regnaDkciN/GenevaClock/STL Files/Full Post.stl

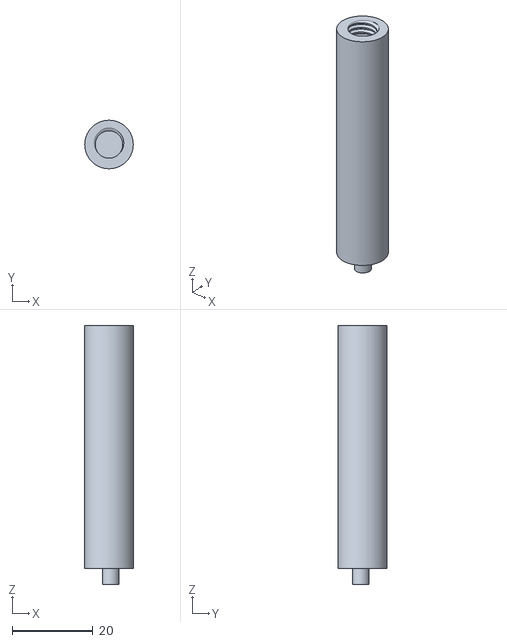
[picture p1: CAD file, 2024-05-16]
STL Files/Full Post.stl
12.0 x 12.0 x 64.0
