regnaDkciN/GenevaClock/STL Files/Geneva Axle.stl

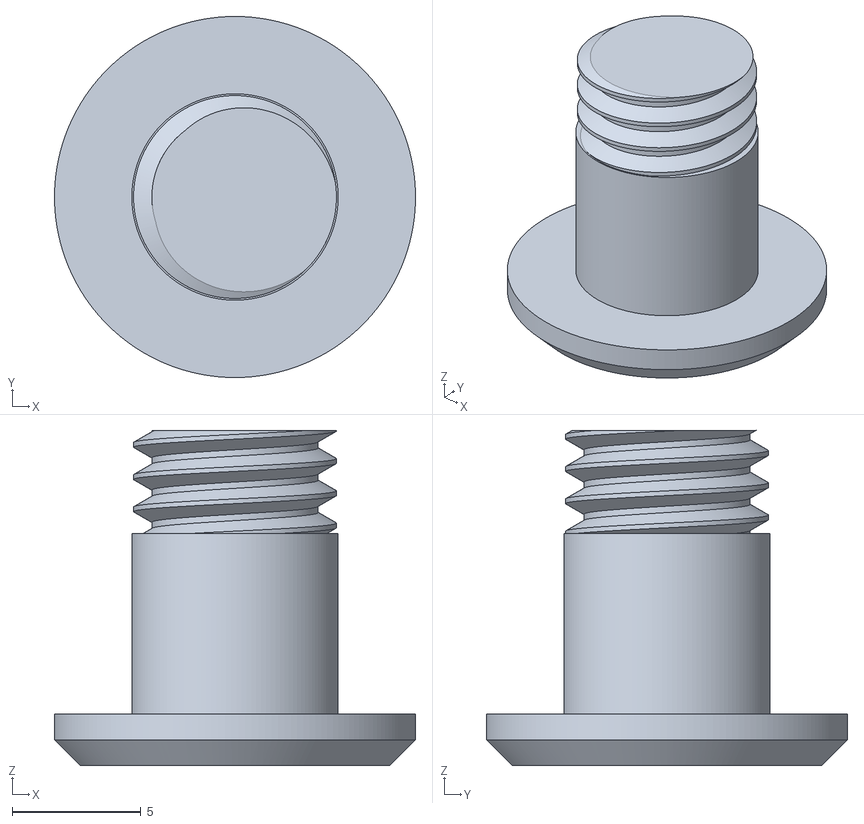
[picture p2: CAD file, 2024-05-16]
STL Files/Geneva Axle.stl
14.0 x 14.0 x 13.0
