regnaDkciN/GenevaClock/STL Files/Gear (1.5m 8t).stl

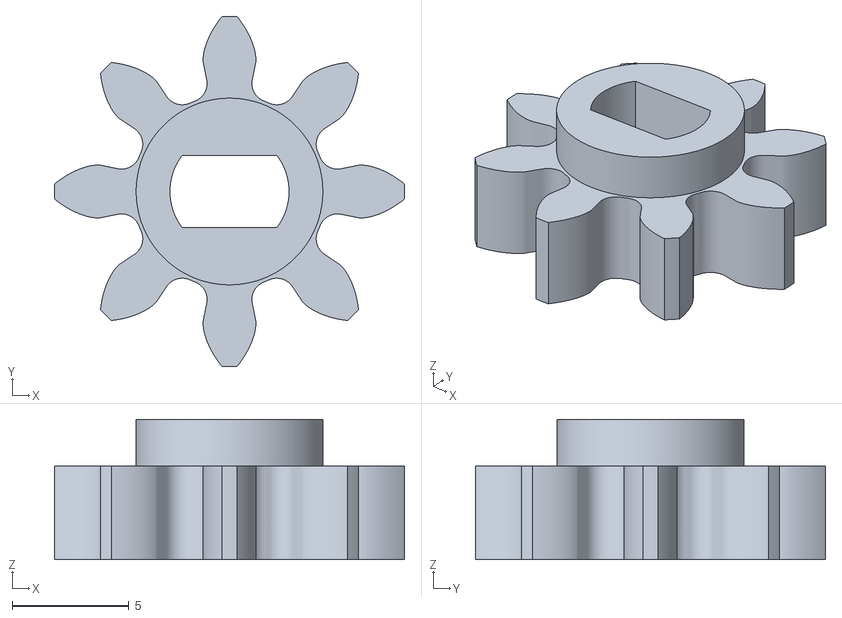
[picture p3: CAD file, 2024-05-16]
STL Files/Gear (1.5m 8t).stl
15.0 x 15.0 x 6.00
