regnaDkciN/GenevaClock/STL Files/Geneva 2 Black.stl

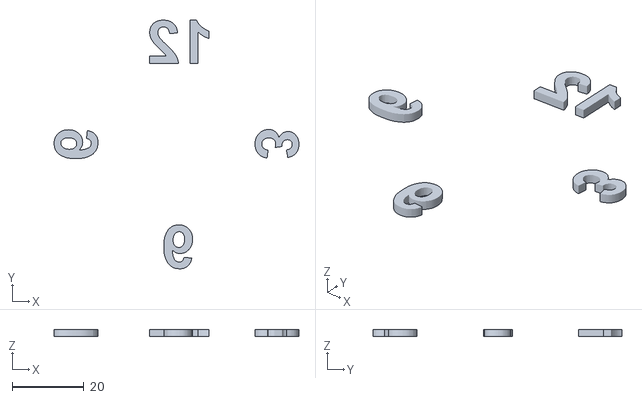
[picture p4: CAD file, 2024-05-16]
STL Files/Geneva 2 Black.stl
68.1 x 69.2 x 2.00
