regnaDkciN/GenevaClock/STL Files/Geneva Clock Box Lid.stl

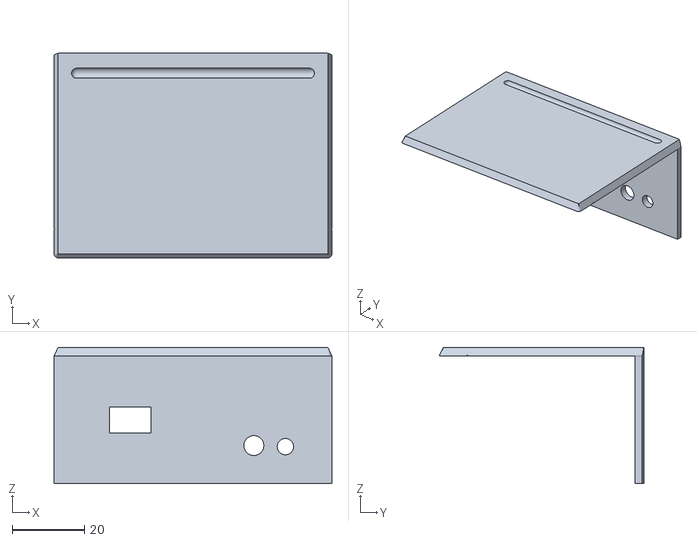
[picture p5: CAD file, 2024-05-16]
STL Files/Geneva Clock Box Lid.stl
76.7 x 56.5 x 37.6
