regnaDkciN/GenevaClock/STL Files/Face Black.stl

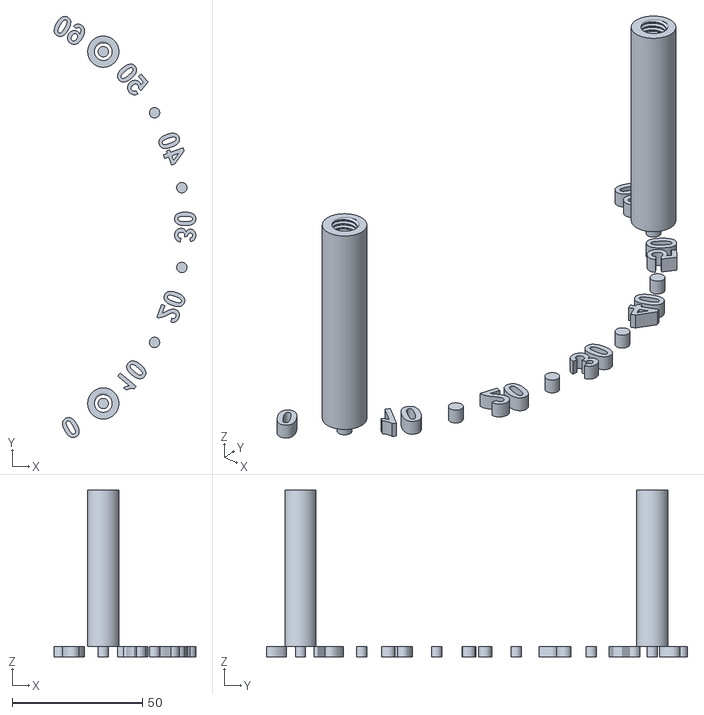
[picture p6: CAD file, 2024-05-16]
STL Files/Face Black.stl
54.3 x 161.5 x 64.0
