regnaDkciN/GenevaClock/STL Files/Geneva 1 White.stl

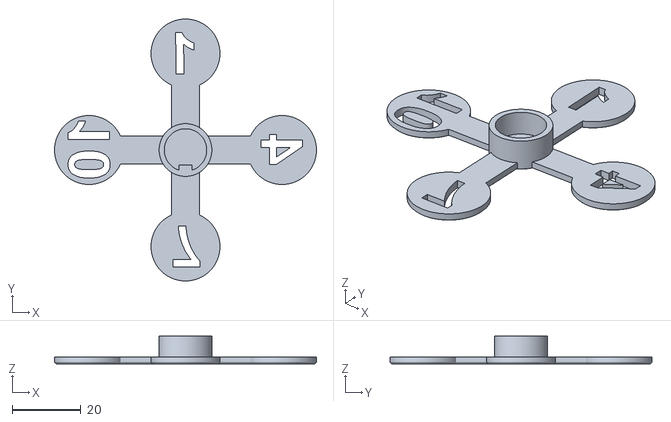
[picture p7: CAD file, 2024-05-16]
STL Files/Geneva 1 White.stl
76.0 x 76.0 x 8.00
