regnaDkciN/GenevaClock/STL Files/Cam.stl

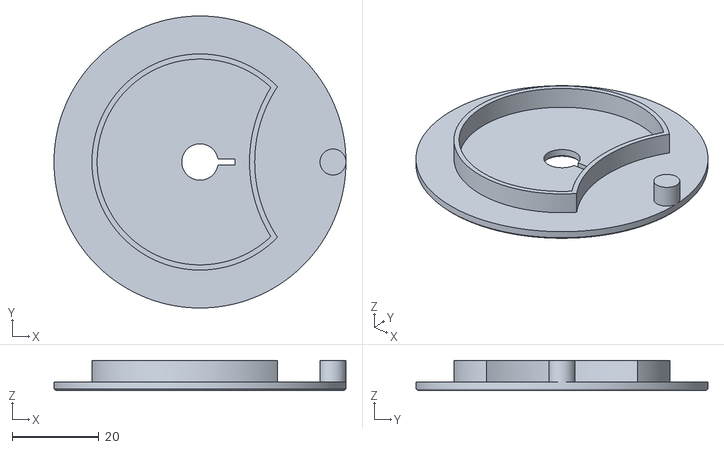
[picture p9: CAD file, 2024-05-16]
STL Files/Cam.stl
67.4 x 67.4 x 7.00
