regnaDkciN/GenevaClock/STL Files/Face.3mf

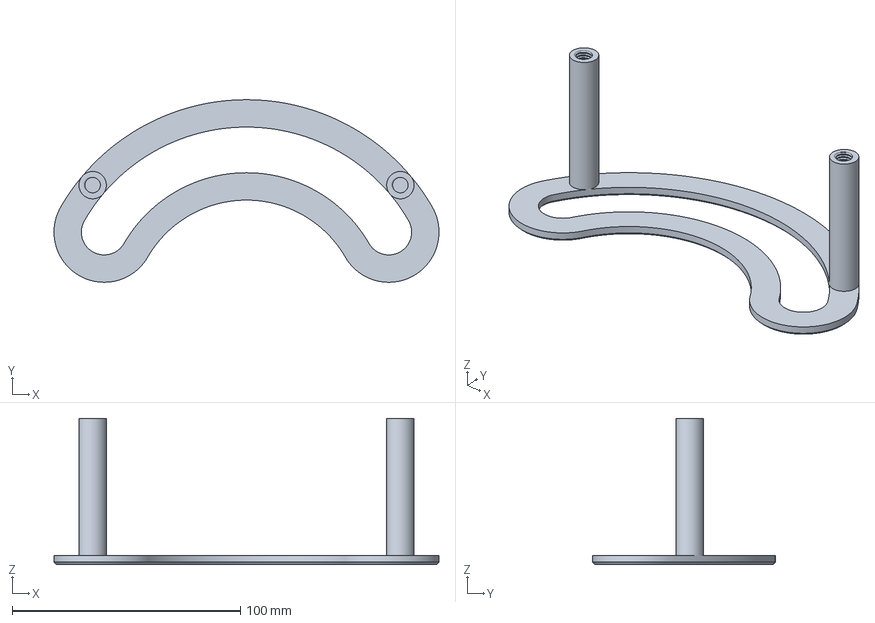
[picture p11: CAD file, 2024-05-16]
STL Files/Face.3mf
168.7 x 80.0 x 64.0 mm
