regnaDkciN/GenevaClock/STL Files/Reed Mount.stl

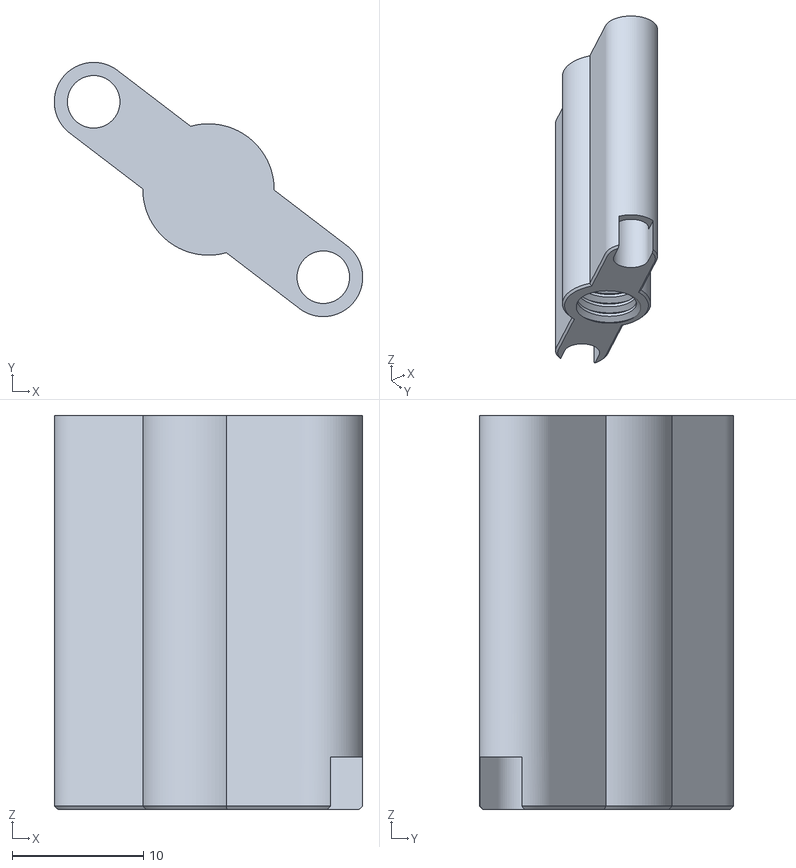
[picture p12: CAD file, 2024-05-16]
STL Files/Reed Mount.stl
23.5 x 19.4 x 30.0
