regnaDkciN/GenevaClock/STL Files/Bracket.stl

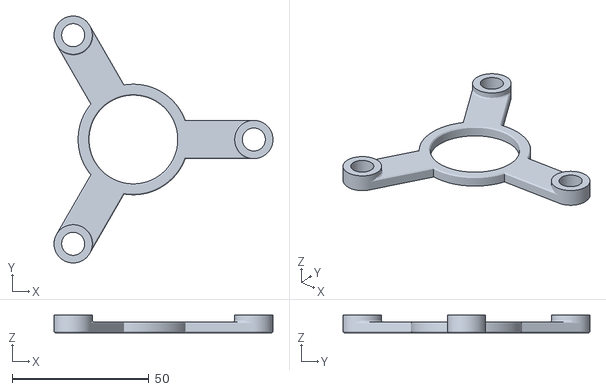
[picture p13: CAD file, 2024-05-16]
STL Files/Bracket.stl
80.0 x 90.2 x 6.40
