regnaDkciN/GenevaClock/STL Files/Back.stl

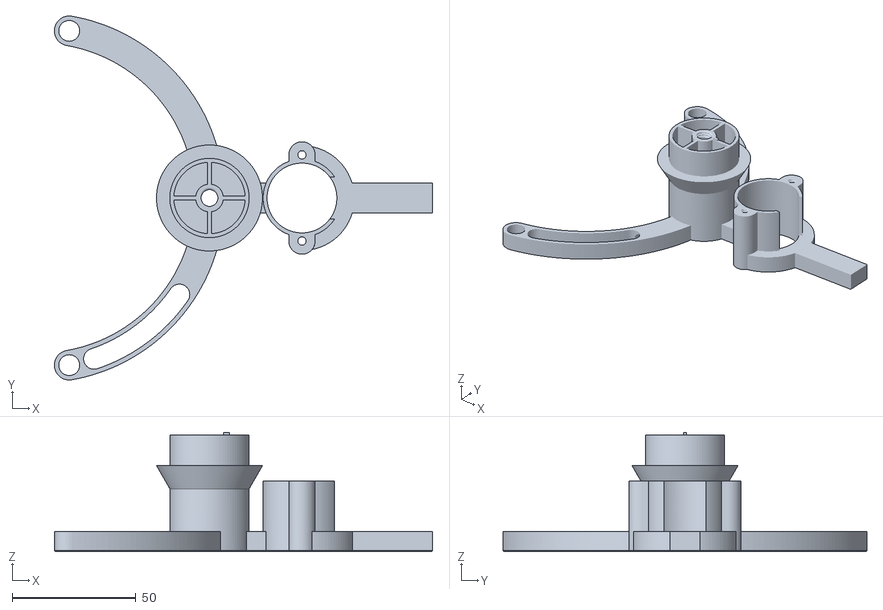
[picture p14: CAD file, 2024-05-16]
STL Files/Back.stl
152.6 x 146.8 x 48.0
