regnaDkciN/GenevaClock/STL Files/Stand.stl

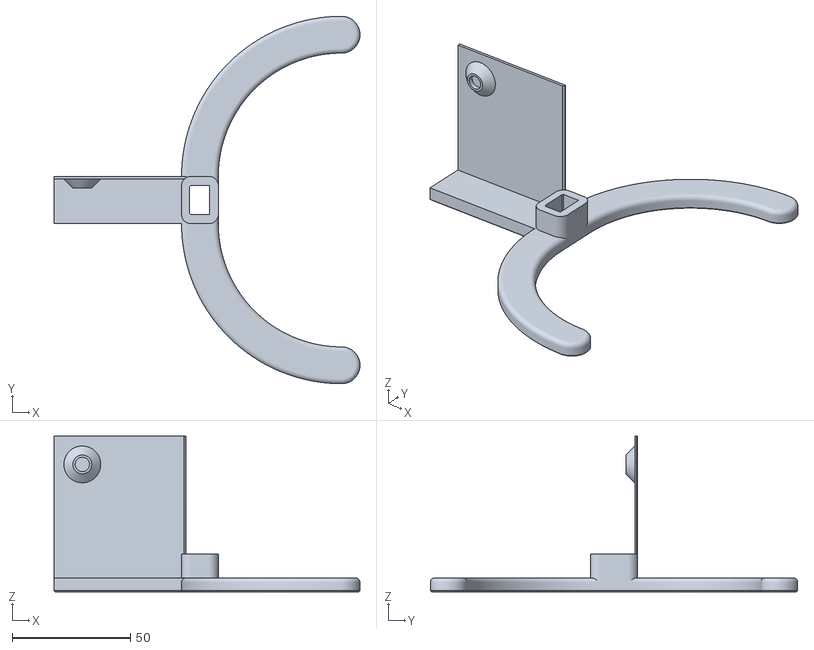
[picture p15: CAD file, 2024-05-16]
STL Files/Stand.stl
129.6 x 155.6 x 66.0
