regnaDkciN/GenevaClock/STL Files/Face With Mounts.stl

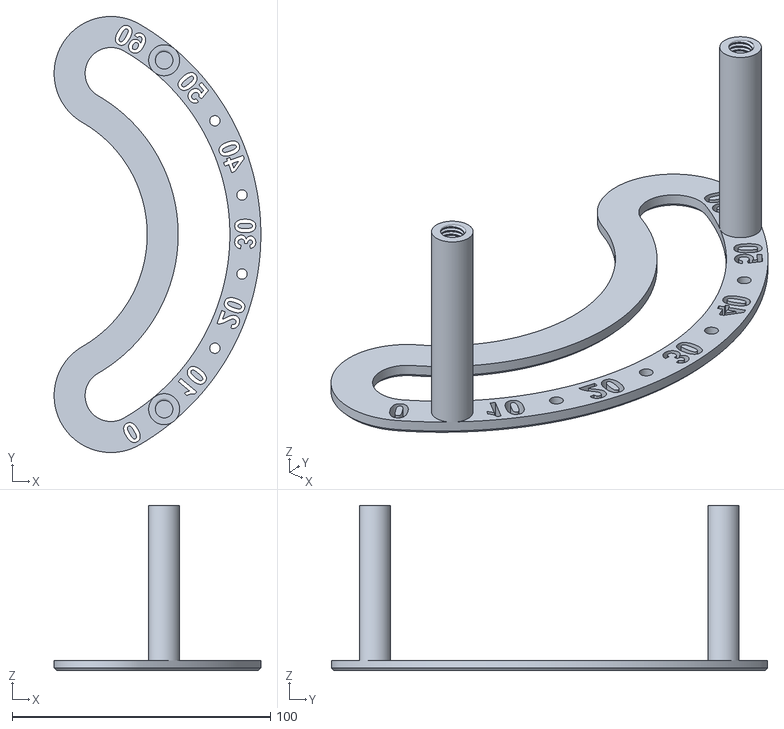
[picture p16: CAD file, 2024-05-16]
STL Files/Face With Mounts.stl
80.0 x 168.7 x 64.0
