regnaDkciN/GenevaClock/STL Files/Geneva 2.3mf

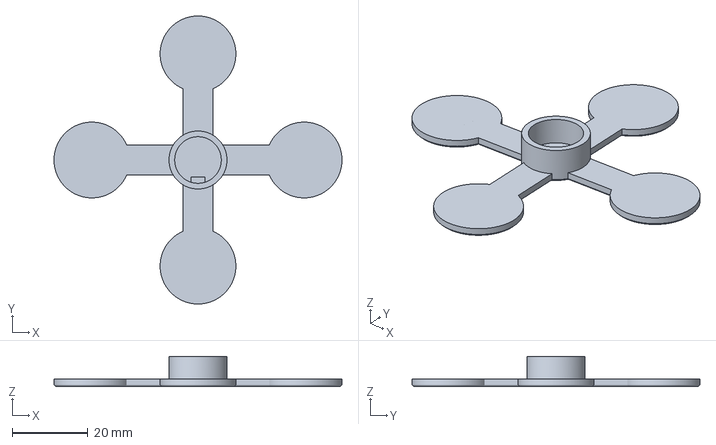
[picture p17: CAD file, 2024-05-16]
STL Files/Geneva 2.3mf
76.0 x 76.0 x 8.00 mm
