regnaDkciN/GenevaClock/STL Files/Geneva 1 Black.stl

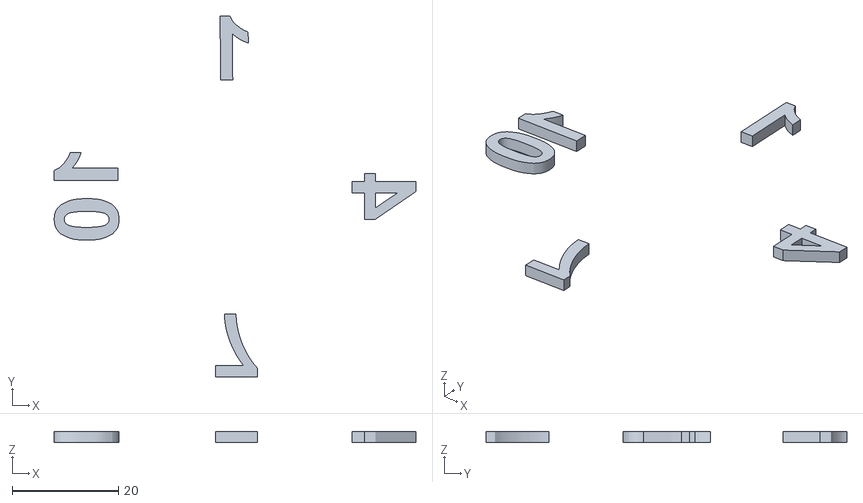
[picture p18: CAD file, 2024-05-16]
STL Files/Geneva 1 Black.stl
68.1 x 67.9 x 2.00
