regnaDkciN/GenevaClock/STL Files/Face White.stl

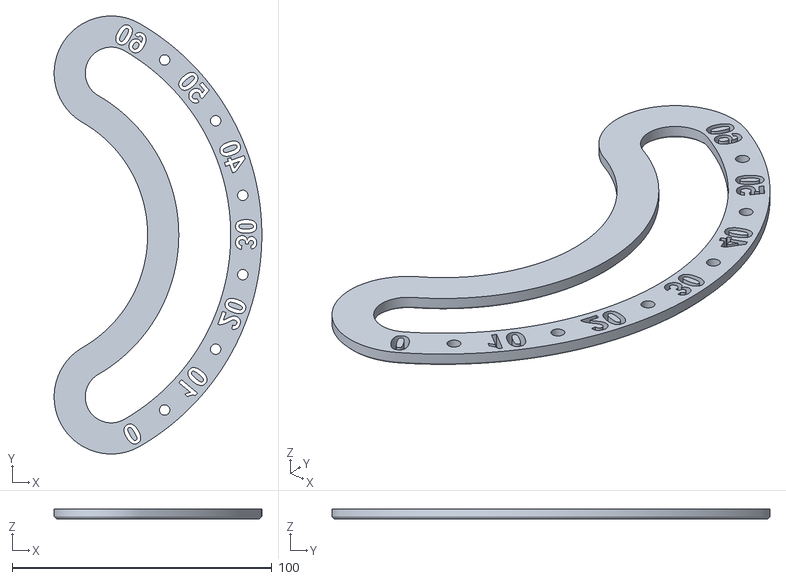
[picture p19: CAD file, 2024-05-16]
STL Files/Face White.stl
80.0 x 168.7 x 4.00
