regnaDkciN/GenevaClock/STL Files/StandModified.stl

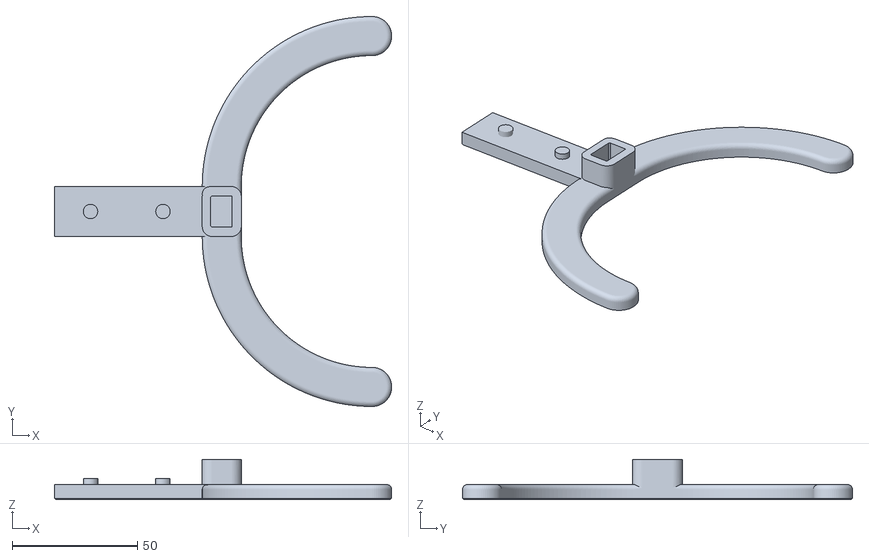
[picture p20: CAD file, 2024-05-16]
STL Files/StandModified.stl
134.6 x 155.6 x 16.0
