regnaDkciN/GenevaClock/STL Files/Geneva 3 Black.stl

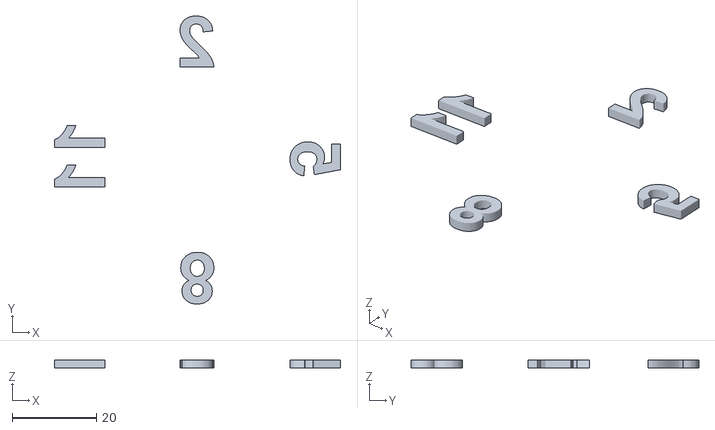
[picture p21: CAD file, 2024-05-16]
STL Files/Geneva 3 Black.stl
67.9 x 68.3 x 2.00
