regnaDkciN/GenevaClock/STL Files/Reed Mount Cover.stl

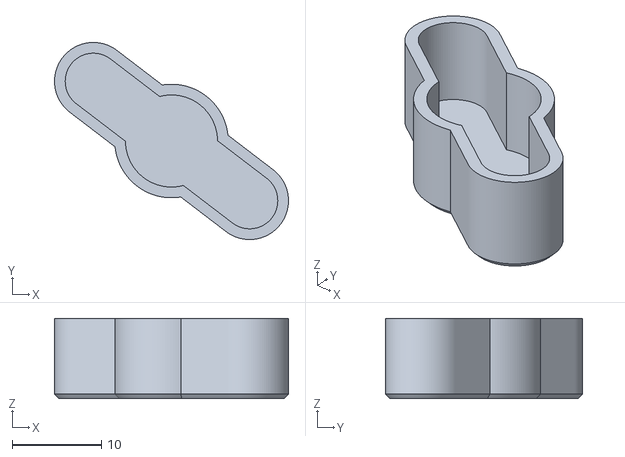
[picture p22: CAD file, 2024-05-16]
STL Files/Reed Mount Cover.stl
26.2 x 22.1 x 9.00
