regnaDkciN/GenevaClock/STL Files/Geneva Clock Box.stl

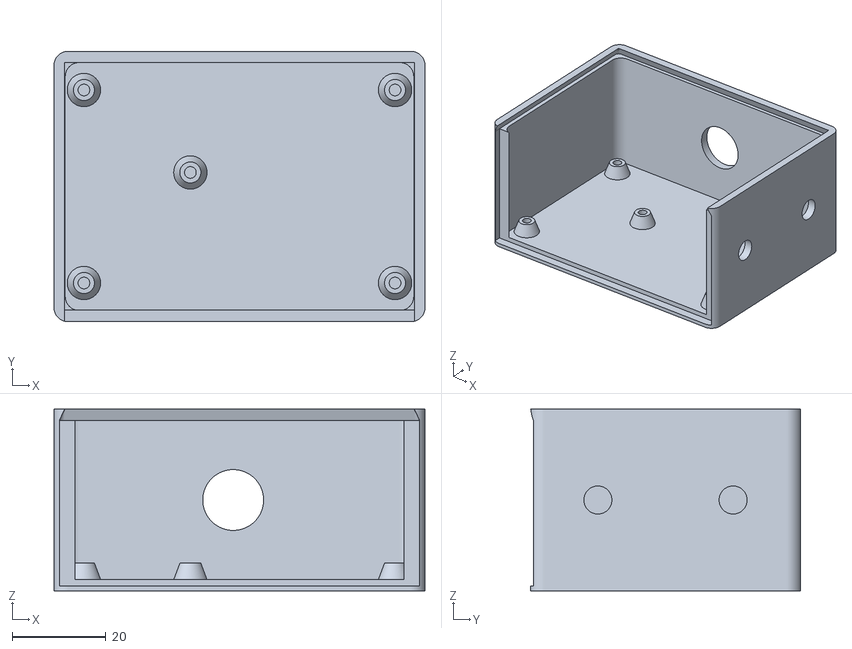
[picture p23: CAD file, 2024-05-16]
STL Files/Geneva Clock Box.stl
79.3 x 57.8 x 38.8
