regnaDkciN/GenevaClock/STL Files/LEDHolder.stl

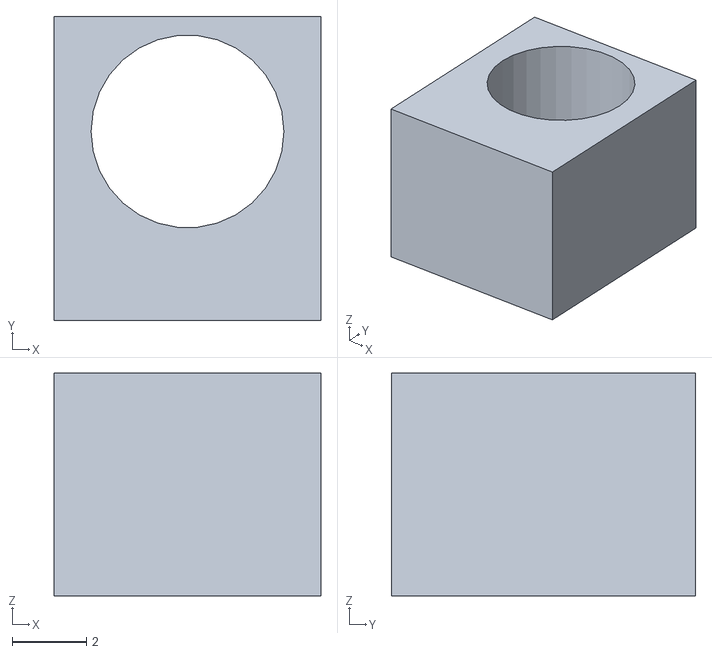
[picture p24: CAD file, 2024-05-16]
STL Files/LEDHolder.stl
7.20 x 8.20 x 6.00
