regnaDkciN/GenevaClock/STL Files/Gear (1.5m 32t).stl

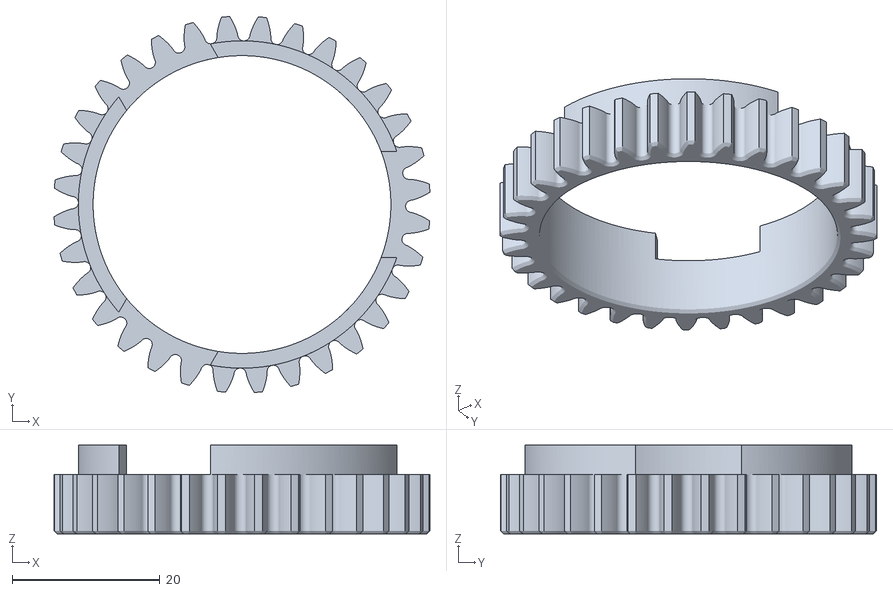
[picture p25: CAD file, 2024-05-16]
STL Files/Gear (1.5m 32t).stl
50.9 x 50.9 x 12.0
