regnaDkciN/GenevaClock/(list of files, cad)

Other CAD files:
STL Files/Face Black Post.stl
STL Files/Geneva 2 White.stl
STL Files/Geneva 3 White.stl
STL Files/Bolt (M8 by 1.25 by 12).stl
STL Files/Bolt, Motor.stl
STL Files/Geneva 1.stl
STL Files/Geneva 2.stl
STL Files/Geneva 3.stl
