regnaDkciN/GenevaClock/(commit log)

2024-05-16 Original release of Geneva Clock using Generic Clock Board. See Generic Clock Board for latest board library.
    [Back.stl, Bolt (M8 by 1.25 by 12).stl, Bolt, Motor.stl, Bracket.stl, Cam.stl, Common Constants.scad, Face Black Post.stl, Face Black.stl]
2024-05-18 Added Readme.md plus minor fixes.
    [Face Mount.scad]
2024-06-01 Add comment to consider shortening post.
    [Face Mount.scad]
